Jeremy-ROYER/NespressArduino/README.md

# NespressArduino
Connected Coffee Machine
