Jeremy-ROYER/NespressArduino/Diagramme de Gantt.pdf

| Séance 1 | Séance 2 | Séance 3 | Séance 4 | Séance 5 | Séance 6 | Séance 7 | Séance 8

Montage

Rail + Transporteur

Ouverture cafetière

Taille du café

Capsule

Communication RF

Finalisation

Louis
Jeremy
